Projet-M2-GGB/Pilotage_voiture/Schéma_Vpng/Assemblage.png

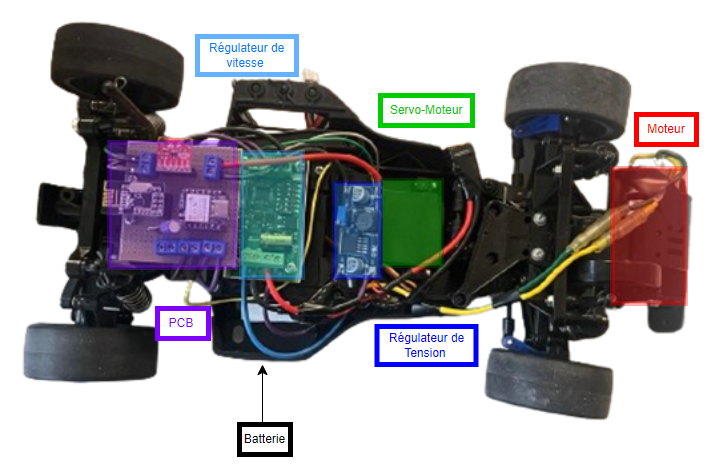
Schéma_Vpng/Assemblage.png
