Projet-M2-GGB/Pilotage_voiture/Schéma_Vpng/Cablage.png

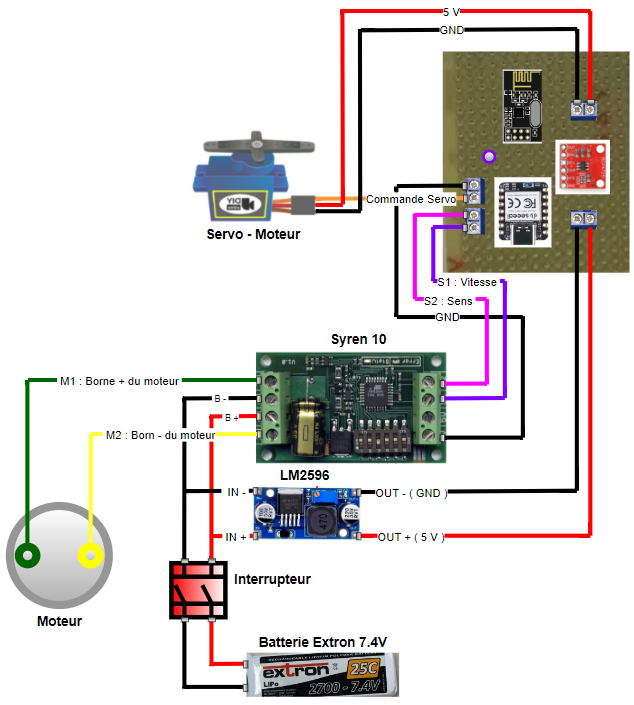
Schéma_Vpng/Cablage.png
