Projet-M2-GGB/Pilotage_voiture/Ressources_utiles_voiture/Grafcet_voiture_final.png

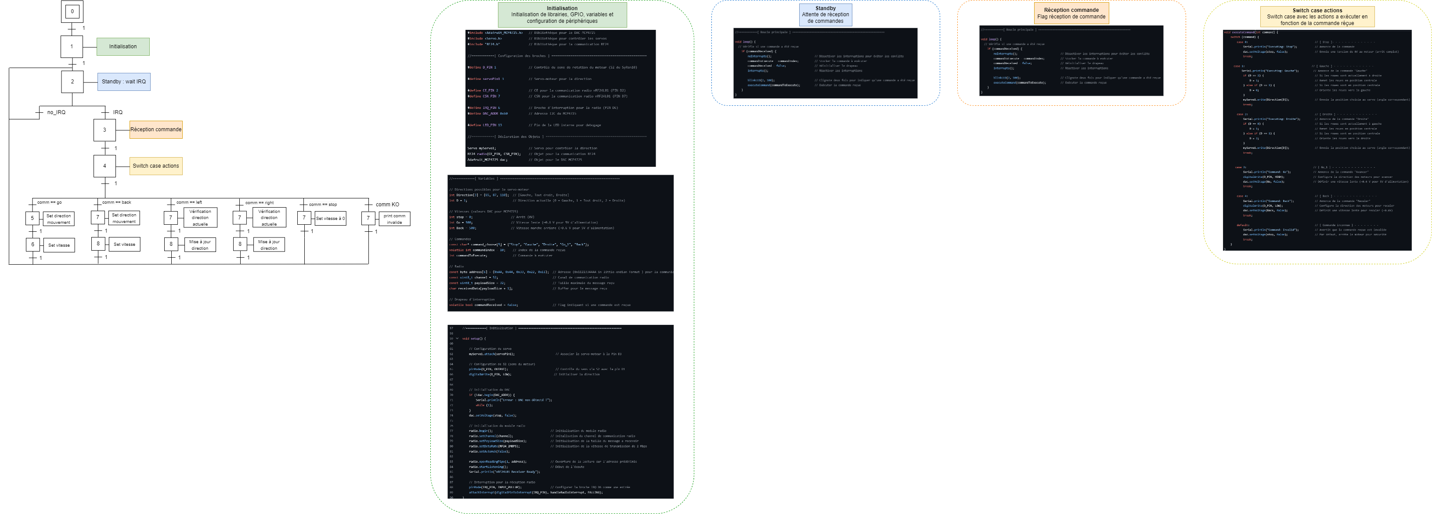
Ressources_utiles_voiture/Grafcet_voiture_final.png
