Projet-M2-GGB/Pilotage_voiture/Schéma_Vpng/Cablage_BCP.png

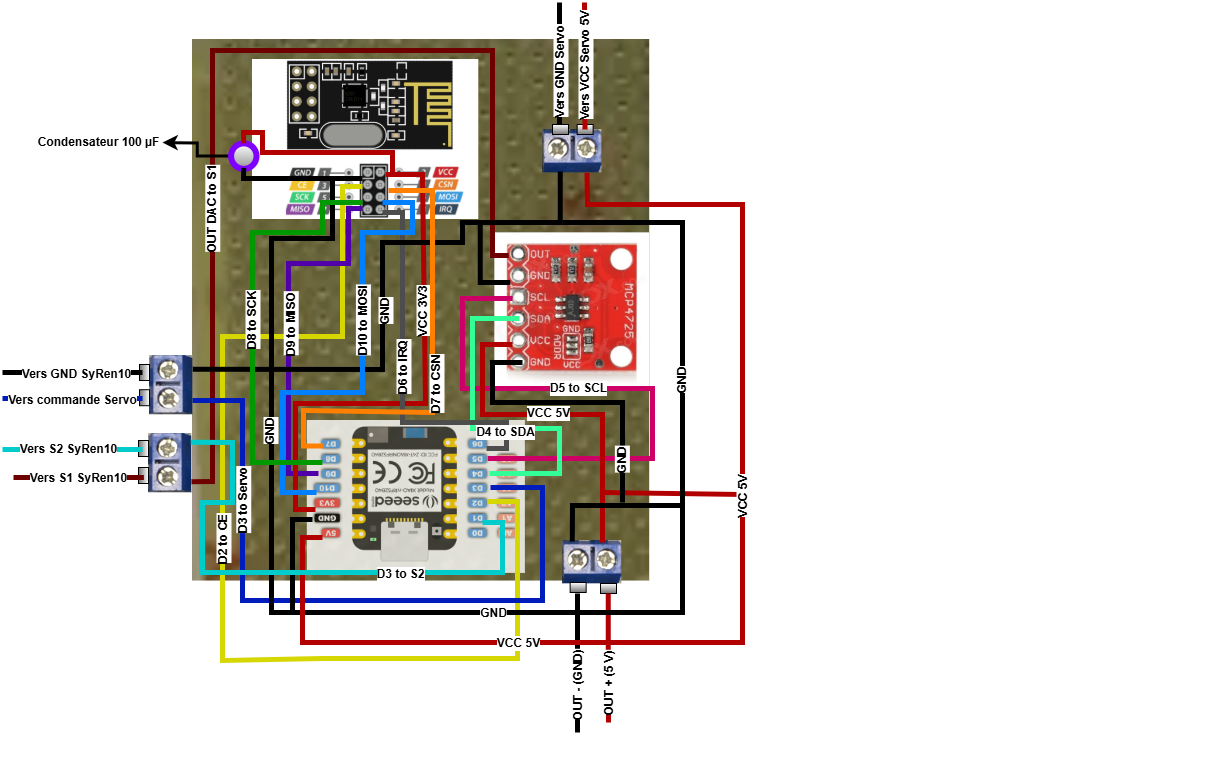
Schéma_Vpng/Cablage_BCP.png
