Projet-M2-GGB/Pilotage_voiture/Schéma_Vpng/Diagrammes_electriques_projet.png

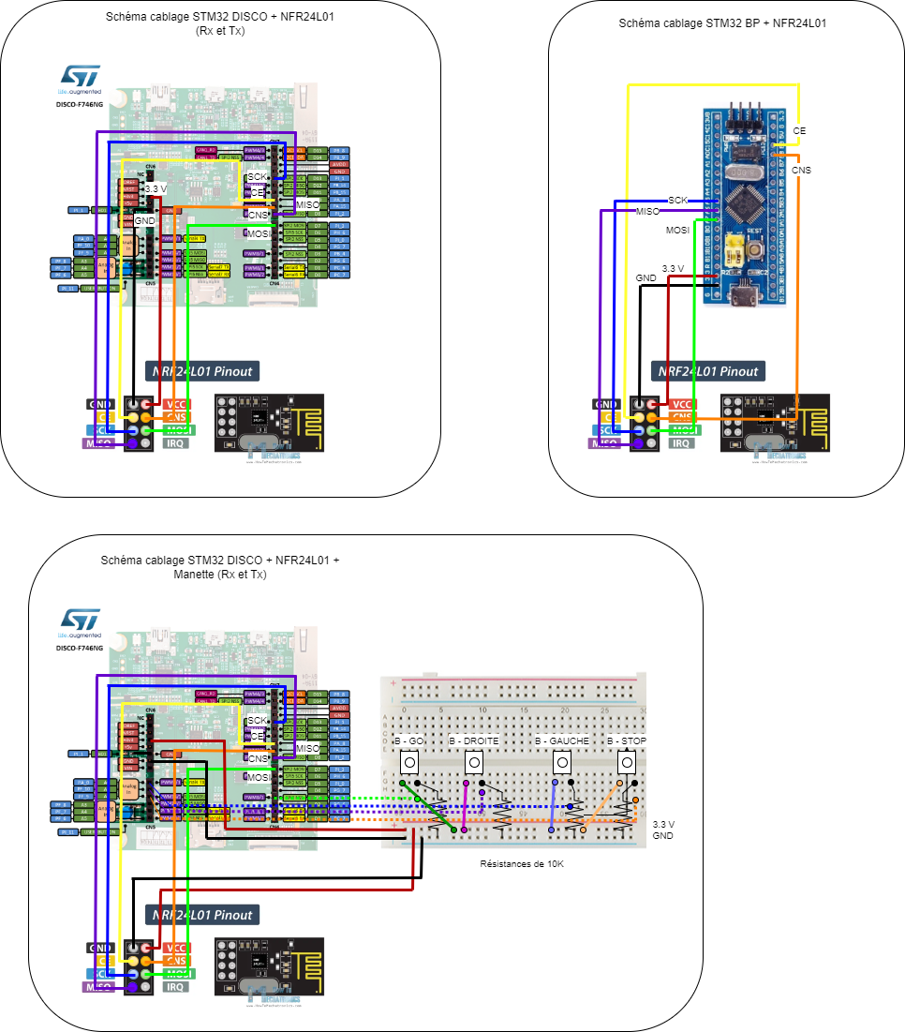
Schéma_Vpng/Diagrammes_electriques_projet.png
