Projet-M2-GGB/Pilotage_voiture/Schéma_Vpng/Schéma électrique.png

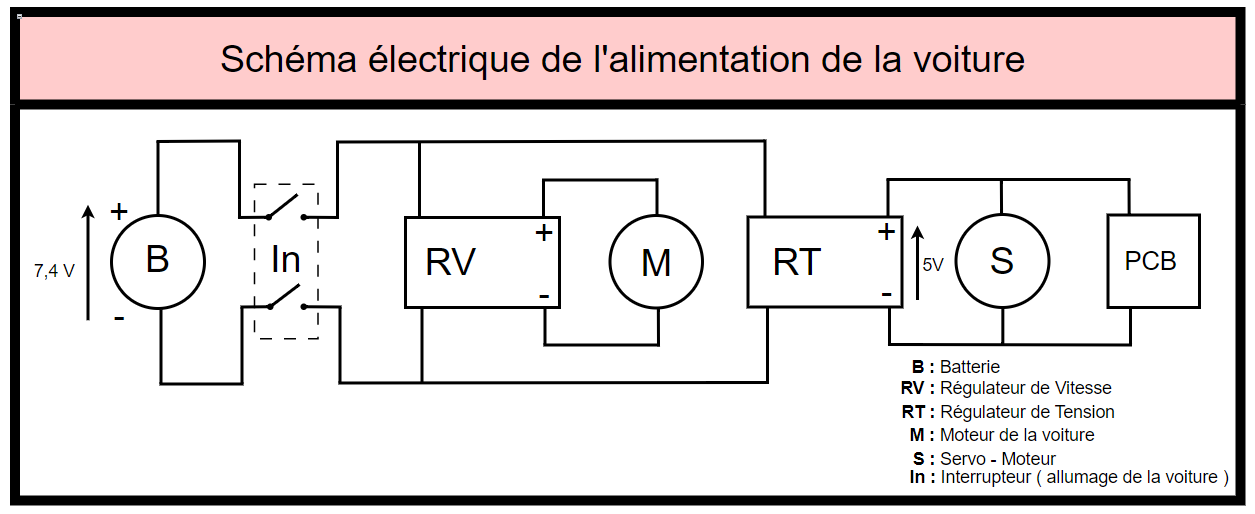
Schéma_Vpng/Schéma électrique.png
